CheungJY/line-following-car-Arduino/支架.SLDPRT

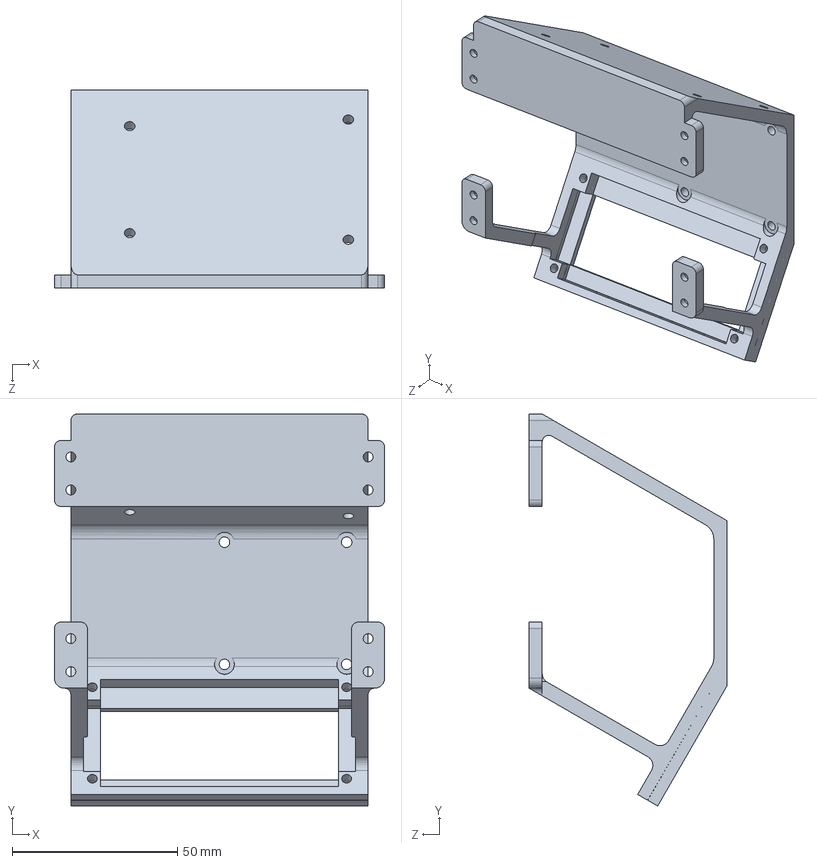
[picture p1: CAD file, 2019-11-18]
支架.SLDPRT
100.0 x 118.7 x 60.0 mm
