CheungJY/line-following-car-Arduino/底盘.SLDPRT

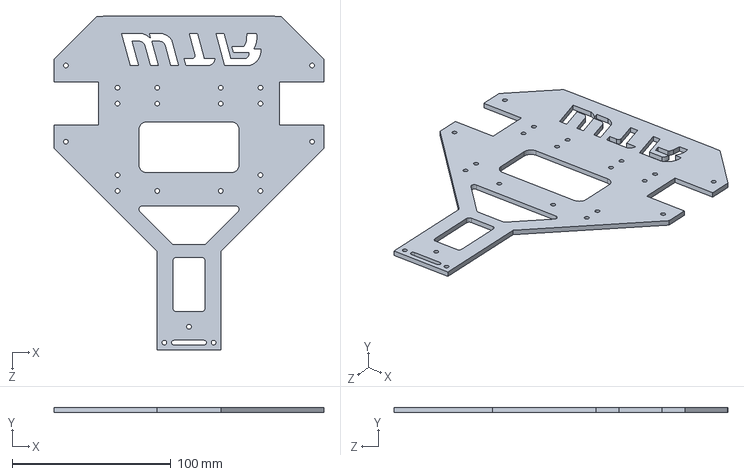
[picture p2: CAD file, 2019-11-17]
底盘.SLDPRT
170.0 x 3.00 x 210.0 mm
