CheungJY/line-following-car-Arduino/电机座.SLDPRT

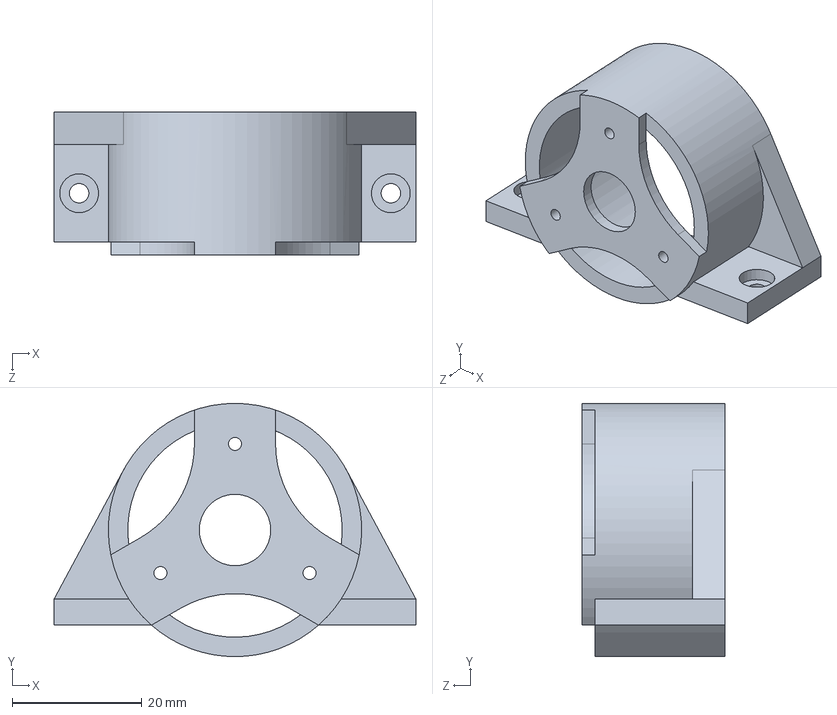
[picture p3: CAD file, 2019-11-15]
电机座.SLDPRT
55.7 x 39.0 x 22.0 mm
