CheungJY/line-following-car-Arduino/海绵轮.SLDPRT

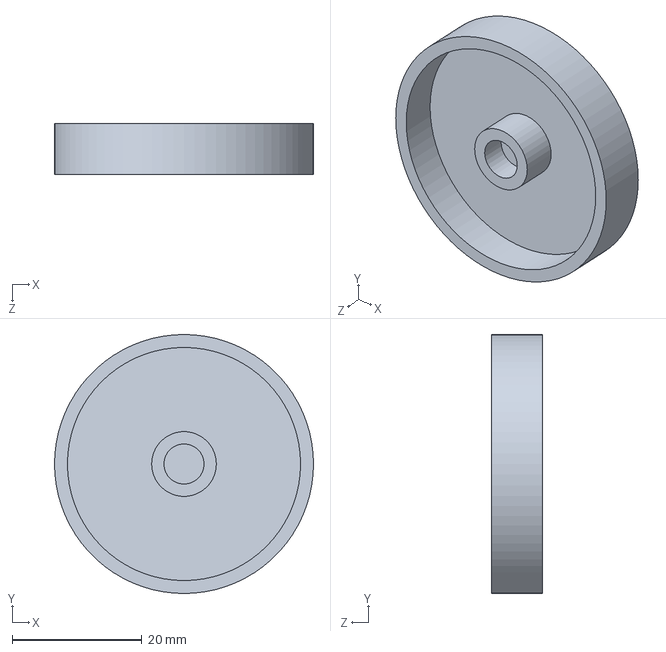
[picture p4: CAD file, 2019-11-15]
海绵轮.SLDPRT
40.0 x 40.0 x 7.80 mm
