CheungJY/line-following-car-Arduino/(commit log)

2019-11-15 Create 图纸
2019-11-15 while with foam tyre
    [海绵轮.SLDPRT]
2019-11-15 motor seat
    [电机座.SLDPRT]
2019-11-18 支架
    孔位精度不够 前面arduino孔位打反了 但是后来用电焊打了新孔位
    [支架.SLDPRT]
2019-11-18 带有PID算法的电机控制程序
    想要让电机保持什么转速直接改定义中want_PWM_left/right的值即可。。。。。。
    我设置了60 然后发生了车祸。。。转接板板大量针脚撞歪 右侧电机莫名其妙无法转动
    看来要弃一段时间等新的转接板到了
    警告：测验请务必从较低的设定转速开始测验！
2019-11-22 11.22更新
    使用HC-05蓝牙模块 可以遥控前进 后退 转弯
    因为我的两个电机差距较大，前进时左电机加速较快，所以添加前馈来保持左右轮加速同步
    代码中含有一段被注释掉的二级PID，因为怎么调都不够立项故放弃，使用了简单粗暴的前馈
2019-11-22 update 11/22
    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
